RobinMeis/Junkers_1-2-4_ESP32/(threads)

Thread 2 (2023-11-26):

Problems with mqttconnect (I think)

exbibe, 2023-11-26:
Hello, thank you for this great project.

I built it up and compiled the software properly, but after wifi - connect the ESP32 goes into a bootloop. When the function mqttconnect is uncommented, the script works (I think :-)) So I think, the Mqtt - function is the problem,.

here is the serial Output:

> WiFi connected
IP address: 192.168.178.173
Sunday, November 26 2023 20:32:50
Guru Meditation Error: Core  1 panic'ed (InstrFetchProhibited). Exception was unhandled.

> Core`  1 register dump:
PC      : 0x860239f0  PS      : 0x00060330  A0      : 0x80140870  A1      : 0x3ffcae50
A2      : 0x40152fd4  A3      : 0x3ffcaeb0  A4      : 0x3ffcaf20  A5      : 0x00000001
A6      : 0x860239f0  A7      : 0x0338fffd  A8      : 0x801405e4  A9      : 0x0000000a
A10     : 0x00000001  A11     : 0x0000000a  A12     : 0x26004136  A13     : 0x24260614
A14     : 0x40152fd4  A15     : 0x3ffcaeb0  SAR     : 0x00000020  EXCCAUSE: 0x00000014
EXCVADDR: 0x860239f0  LBEG    : 0x4008aed1  LEND    : 0x4008aee1  LCOUNT  : 0xffffffff

> Backtrace: 0x460239ed:0x3ffcae50 0x4014086d:0x3ffcaeb0 0x400d3a8f:0x3ffcaf50 0x400d3af9:0x3ffcafa0 0x400d992b:0x3ffcafd0

If you have any suggestions, I would be very thankful.

exbibe, 2023-11-27:
Hallo, ich glaube wir können auf Deutsch umstellen, wollte nur bei GITHUB die Gepflogenheiten wahren.

Also ich habe in der firmware.ino //mqttconnect(); auskommentiert. Dann verbindet sich der ESP mit dem Wlan und hängt natürlich dann im Mqtt loop fest.  Allerdings kommt es dann nicht mehr zum Bootloop. Daher denke ich, dass irgendwas in dem Code dafür sorgt, bzw. Ein Aufruf dessen.

Ich habe bereits zwei esp32 wroom 32 getestet (wie im Projekt), aber bei beiden der gleiche Fehler. Auf jeden Fall sehr seltsam. Leider kann ich nichts finden.

bool mqttConnect() {
  client.setServer(
    MQTT_SERVER, //Server
    MQTT_PORT //Port
  );
  client.connect(
    "heater",
    MQTT_USER, //Username
    MQTT_PASSWORD, //Username
    "heater/status", //Will Topic
    2, //Will QoS
    1, //Will retain
    "Offline" //Will message
  );

  client.publish("heater/status", "Online", true); //Report as online
  subscribe();
  client.setCallback(callback);
}

Herzliche Grüße

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

RobinMeis, 2023-11-27:
Kannst du denn mal die Befehle in der mqttConnect einzeln auskommentieren, damit wir den Fehler auf den entsprechenden Aufruf eingrenzen können? Eventuell hilft auch ein Downgrade der MQTT Bibliothek. Ich habe leider gerade keinen ESP da, an dem ich das mal testen könnte.

RobinMeis, 2023-11-27:
Das war definitiv ein Fehler, der offensichtlich in älteren Arduino/ESP IDF Versionen nicht aufgefallen ist. Habe ich im Code korrigiert.

Thread 3 (2024-01-28):

Home Assistant

phmllr, 2024-01-28:
Ich habe ewig nach einer Lösung gesucht meine Junkers endlich smart zu bekommen. Danke für dein Einfallsreichtum! Ich würde das Projekt gerne nachbauen und in HA integrieren( was durch mqtt kein Problem sein sollte)
Doch ich habe eine Frage:
Wie verhält sich die Therme wenn ich sie aus dem standby hole also aktiv setzte und die Raumtemperatur erreicht ist? Schaltet die Therme dann ab?
Hintergrund ist folgender:
Ich habe eine 4 Raum Wohnung und an jedem Heizkörper ein smartes Thermostat. Nun hätte ich es gerne so, dass wenn ein heizkörperthermostat Wärme benötigt, die Therme anspringt. Doch wenn der Temperatursensor an der Platine des ESP sagt Soll und Ist Temp. Sind gleich würde die Therme ja nicht angehen oder ?
Ich hoffe ich habe es halbwegs verständlich erklärt und du kannst mir irgendwie auf die Sprünge helfen.

RobinMeis, 2024-01-28:
Ich habe meine Therme inzwischen auch im Homeassistant. Die Firmware habe ich allerdings nicht dafür angepasst, sondern einen Adapter in Nodered gebaut. Nichts hält ja länger als ein Provisorium.

Grundsätzlich ist es so, dass die Junkers Etagenheizungen Raumgeführt sind. So macht es auch der originale Regler. Dessen Verhalten habe ich damals analysiert und nachgebaut. Der Regler hier stellt damit eigentlich nur eine WLAN Variante des Originals dar. Das von dir beschriebene Problem besteht also tatsächlich. Das ist natürlich eigentlich sehr unpraktisch, weil der Wärmebedarf pro Raum überhaupt nicht berücksichtigt wird. Bei mir hängt hängen Therme und Regler zum Beispiel in der Küche und dort heize ich nur sehr wenig. Die Therme würde also nie abschalten, sondern die Umwälzpumpe immer aktiv bleiben, selbst wenn alle Thermostate geschlossen sind.

Ich habe das bei mir über den Homeassistant automatisiert. Meine Heizungsthermostate geben den Heizbedarf als PI Heating Demand aus. Der Homeassistant setzt dann bei bestehendem Bedarf die Zieltemperatur für die Therme entsprechend hoch. Du müsstest die Zieltemperatur am Regler dann einfach so hoch einstellen, dass sie in dem Führungsraum niemals erreicht werden kann. Leider ist zur 1-2-4 Schnittstelle seitens Junkers nichts dokumentiert. Alles, was dazu bekannt ist, basiert auf eigenen Untersuchungen und vagen Annahmen. Ich kann daher nicht sagen, welche Auswirkungen das dann nicht ganz korrekte Verhalten des Reglers hat. Da das selbe Problem aber auch mit dem Originalregler besteht, mache ich mir da keine Gedanken. Bei mir entscheidet der Regler letztlich nur über An oder Aus. Ob die Flamme gezündet wird entscheidet die Therme schließlich selbst aus der Differenz zwischen Vor- und Rücklauftemperatur.

Das ist natürlich keine ideale Lösung, mehr gibt aber auch eine Integration in den Homeassistant meines Wissens nicht her. Zumindest dann nicht, wenn du die Therme als Temperaturregler einbinden möchtest.

phmllr, 2024-01-28:
Hey danke für die schnelle Antwort!

Wenn ich dich richtig verstehe soll ich die Solltemp. auf z.B 30°C stellen damit es nie erreicht wird. Schaltet die Therme dann von allein ab wenn alle Heizkörper zu sind und Vor und Rücklauf annähernd gleich warm sind?

RobinMeis, 2024-01-28:
Genau so kannst du es machen. Die Therme schaltet allerdings nicht von alleine ab. Die Umwälzpumpe wird weiter gegen die geschlossenen Thermostate anpumpen. Der Heizkreis wird auf Temperatur gehalten. Die Flamme wird also ausgeschaltet, bis der Heizkreis durch Verluste wieder zu weit abgekühlt ist. Dann wird die Flamme wieder zünden, unabhängig davon, ob tatsächlich Heizbedarf besteht. Bei mir hat die Pumpe eine Stromaufnahme von ca. 50 Watt. Auch die werden dann permanent verbraucht.

Daher macht es Sinn, dass du mit einer Automatisierung im Home Assistant den Heizbedarf deiner Thermostate abfragst und die Zieltemperatur des Heizungsreglers wieder auf 5°C bis 10°C zu setzen, um die Therme vollständig abzuschalten. Das hat auch den Vorteil, dass du die Thermostate einfach aufdrehen kannst und die Therme dann automatisch angeht. Sehr praktisch war das auch in den kalten Nächten der letzten zwei Wochen. Da ist die Therme dann auch nachts mal für eine halbe Stunde angesprungen, damit die Räume nicht zu weit auskühlen. Thermostate hatte ich da einfach auf 15°C stehen gelassen.

phmllr, 2024-01-28:
Sehr gut.
Vielen Dank ich werde testen und berichten!

Closed 2024-01-28.
