RobinMeis/Junkers_1-2-4_ESP32/(commit log)

2021-02-01 Add schematic
2021-02-01 User defined init values for temperature and standby
2021-02-01 Reboot if wifi or mqtt failures persist
    [firmware.ino, mqtt.ino]
2022-10-18 Fix schematic
